eehackspace/LEDBox/images/thick-front.png

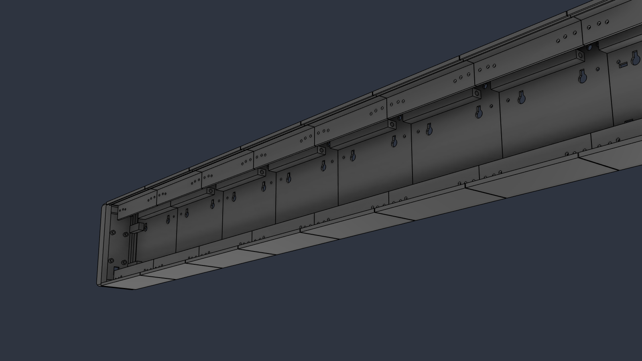
images/thick-front.png
