eehackspace/LEDBox/images/thin-front.png

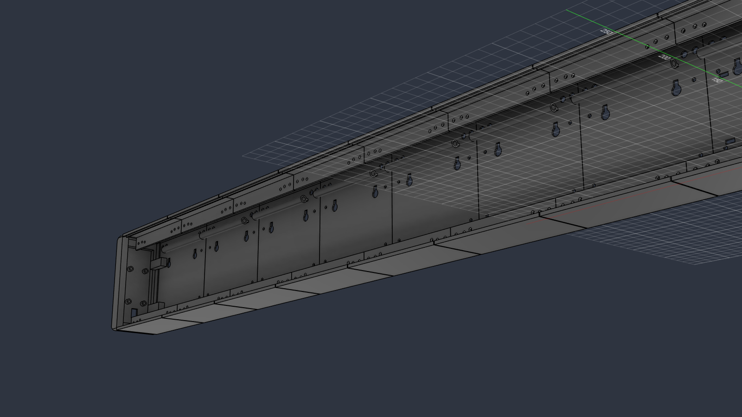
images/thin-front.png
