eehackspace/LEDBox/thin/stl/end-cap-mains.stl

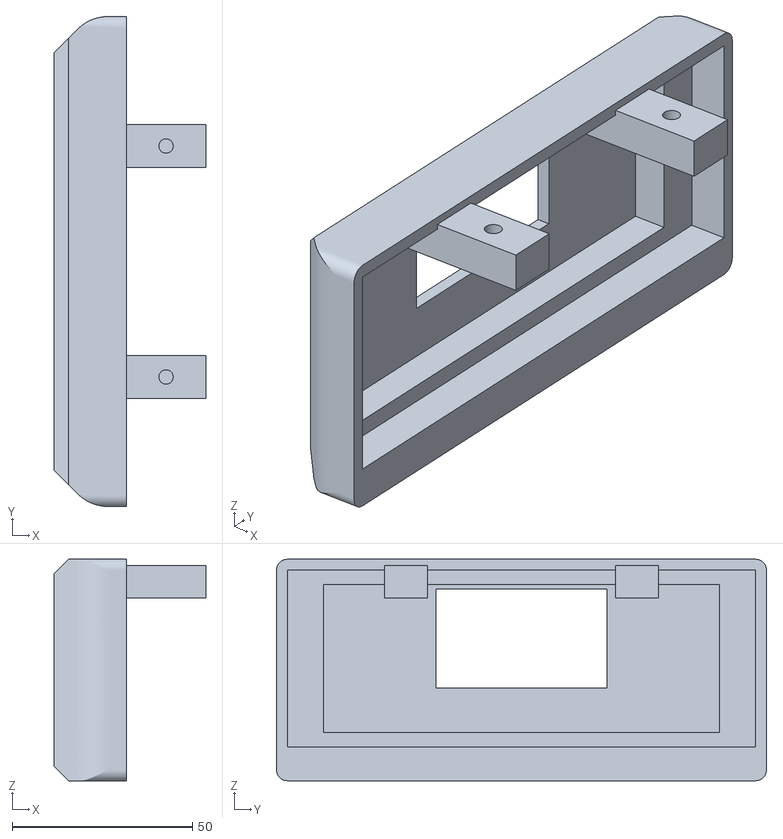
[picture p6: CAD file, 2026-10-10]
thin/stl/end-cap-mains.stl
42.0 x 135.8 x 61.4
