eehackspace/LEDBox/thick/stl/end-cap-controller.stl

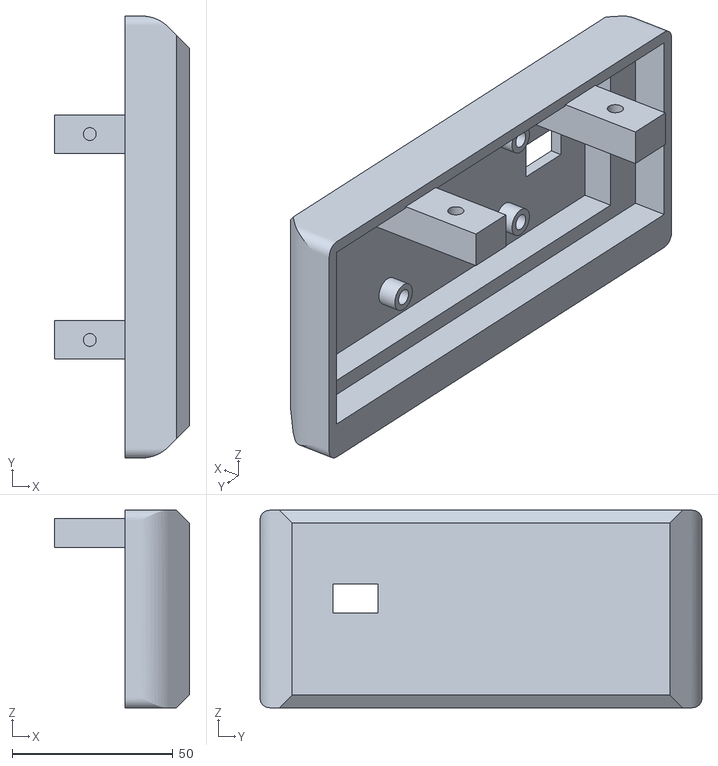
[picture p7: CAD file, 2026-10-10]
thick/stl/end-cap-controller.stl
42.0 x 137.4 x 61.4
