eehackspace/LEDBox/thin/stl/section-plain-mirrored-end.stl

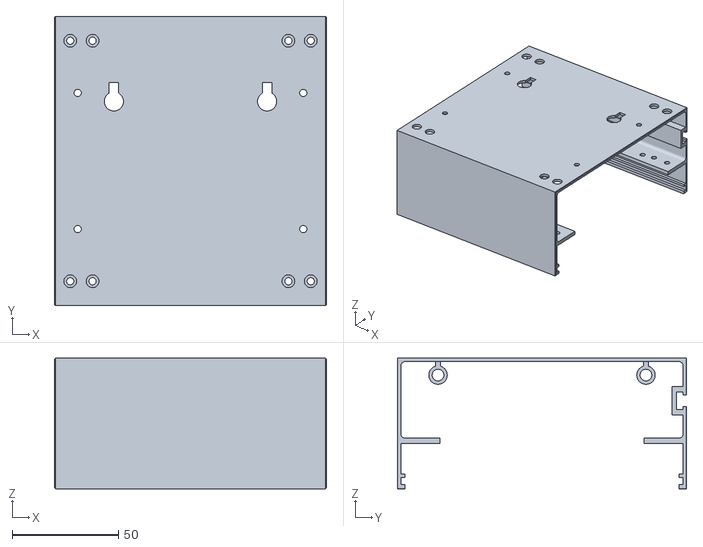
[picture p8: CAD file, 2026-10-10]
thin/stl/section-plain-mirrored-end.stl
127.8 x 135.8 x 61.4
