eehackspace/LEDBox/thick/stl/section-plain.stl

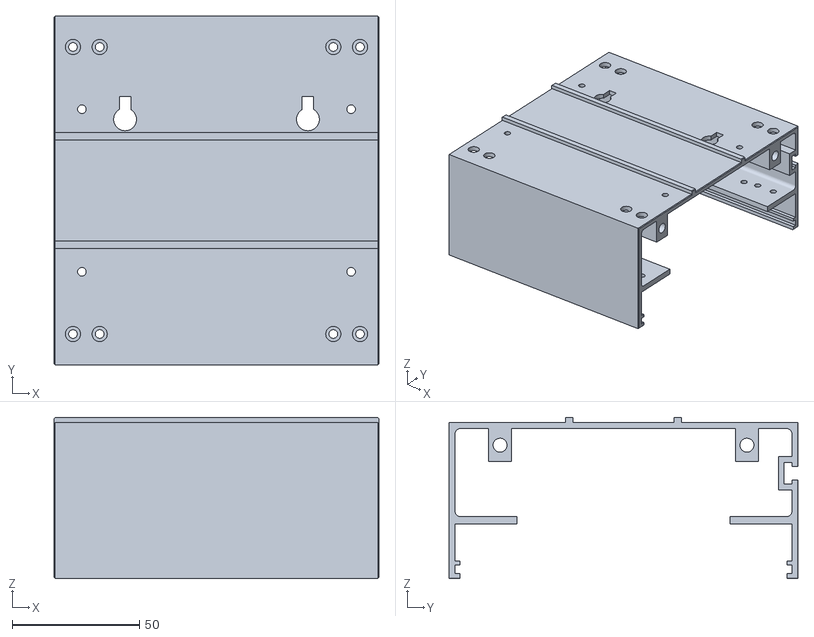
[picture p9: CAD file, 2026-10-10]
thick/stl/section-plain.stl
127.8 x 137.4 x 63.4
