eehackspace/LEDBox/thin/stl/joiner-key.stl

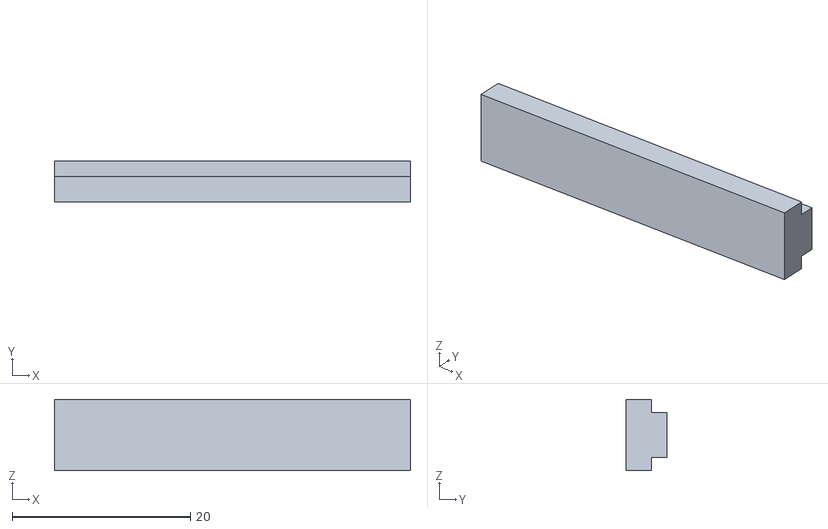
[picture p10: CAD file, 2026-10-10]
thin/stl/joiner-key.stl
40.0 x 4.65 x 8.00
