eehackspace/LEDBox/thick/stl/test-slice.stl

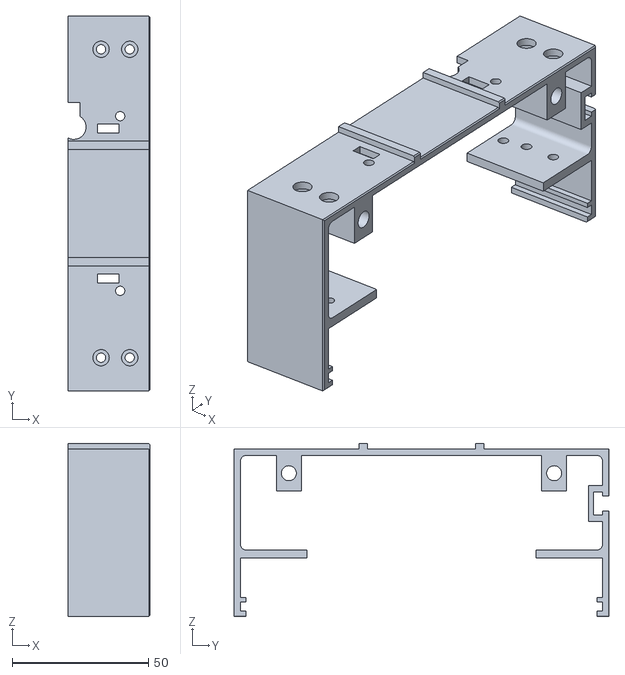
[picture p11: CAD file, 2026-10-10]
thick/stl/test-slice.stl
30.0 x 137.4 x 63.4
