eehackspace/LEDBox/thin/stl/section-vented-psu.stl

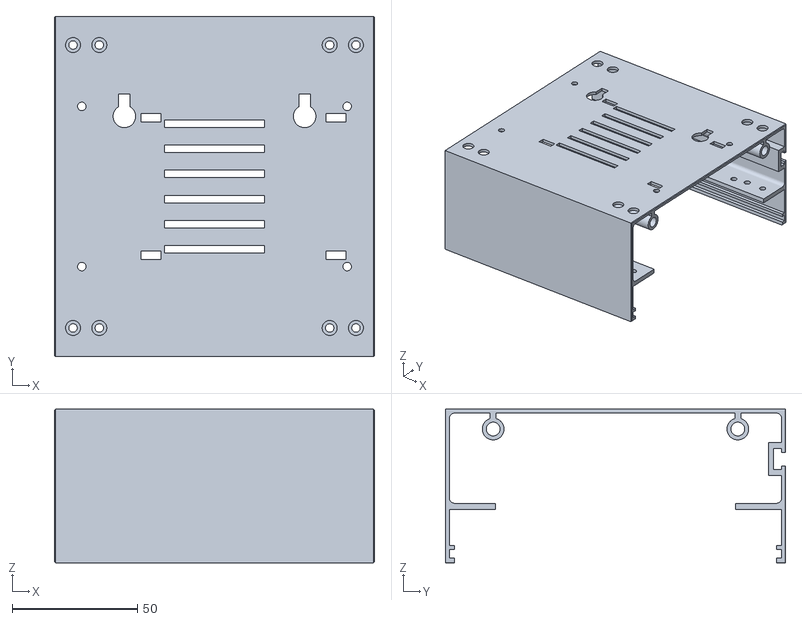
[picture p12: CAD file, 2026-10-10]
thin/stl/section-vented-psu.stl
127.8 x 135.8 x 61.4
