eehackspace/LEDBox/thick/stl/joiner-key.stl

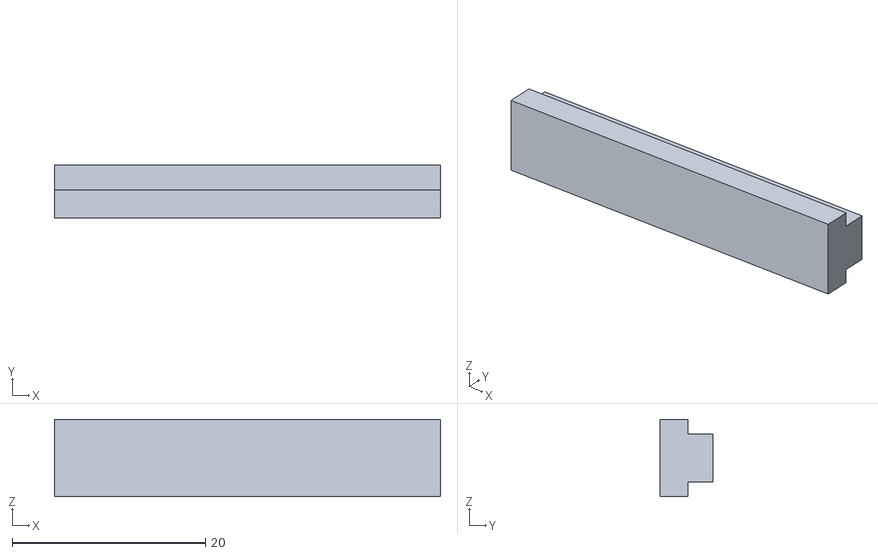
[picture p13: CAD file, 2026-10-10]
thick/stl/joiner-key.stl
40.0 x 5.45 x 8.00
