eehackspace/LEDBox/thin/stl/test-slice.stl

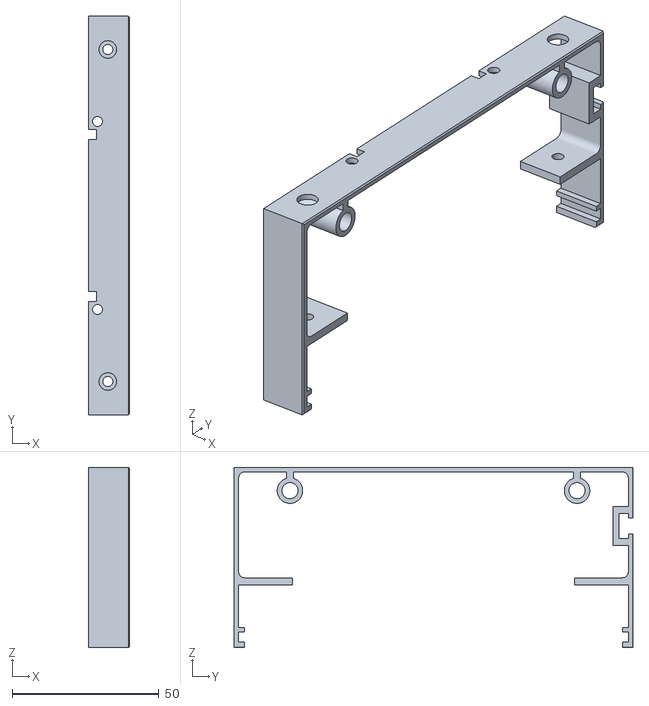
[picture p14: CAD file, 2026-10-10]
thin/stl/test-slice.stl
14.0 x 135.8 x 61.4
