eehackspace/LEDBox/(list of files, cad)

Other CAD files:
thick/stl/end-cap-mains.stl
thick/stl/section-plain-mirrored-end.stl
thin/stl/end-cap-controller.stl
thick/stl/section-vented-psu.stl
thin/stl/section-plain.stl
thick/LEDBox-thick.f3d
thin/LEDBox-thin.f3d
